ergouser/Zivan-NG3/Circuit board pinout.xlsx

5V | 5v | D13 | CLK |  | D12 |  | GND
WDO | A0* | 3v3 |  | SDI | D11 | D9* | Soft Start
 |  | REF |  | CS | D10 | D8* | LED RED
 |  | A0 | WDO | SS | D9 | D7* | LED GREEN
 |  | A1 | Current | LED RED | D8
FANS | A3* | A2 | Voltage | LED GREEN | D7 |  | C0
CS | D10 | A3 | FANS | SOUNDER | D6 |  | C1
SDI | D11 | A4 | SDA screen |  | D5 |  | TP
CLK | D13 | A5 | SCL screen |  | D4 |  | AH
 |  | A6 | Over temp (can't output) |  | D3 | A1* | CURRENT
 |  | A7 | (can't output) |  | D2 | A2* | VOLTAGE
AUX2 |  | 5V | Screen+ |  | GND
AUX1 |  | RST |  |  | RST |  | EXT_TEMP
SOUNDER | D6* | GND | Screen- |  | RX0 | A6* | Over temp
 |  | VIN |  |  | TX1
 |  |  | * = changed comp to previous
