ergouser/Zivan-NG3/(list of files, cad)

Other CAD files:
Zivan NG3 customcircuits dave/Firmware/startup.obj
Zivan NG3 customcircuits dave/Firmware/NGC.obj
