ergouser/Zivan-NG3/Zivan NG3 customcircuits dave/Old_NG3_logic.pdf

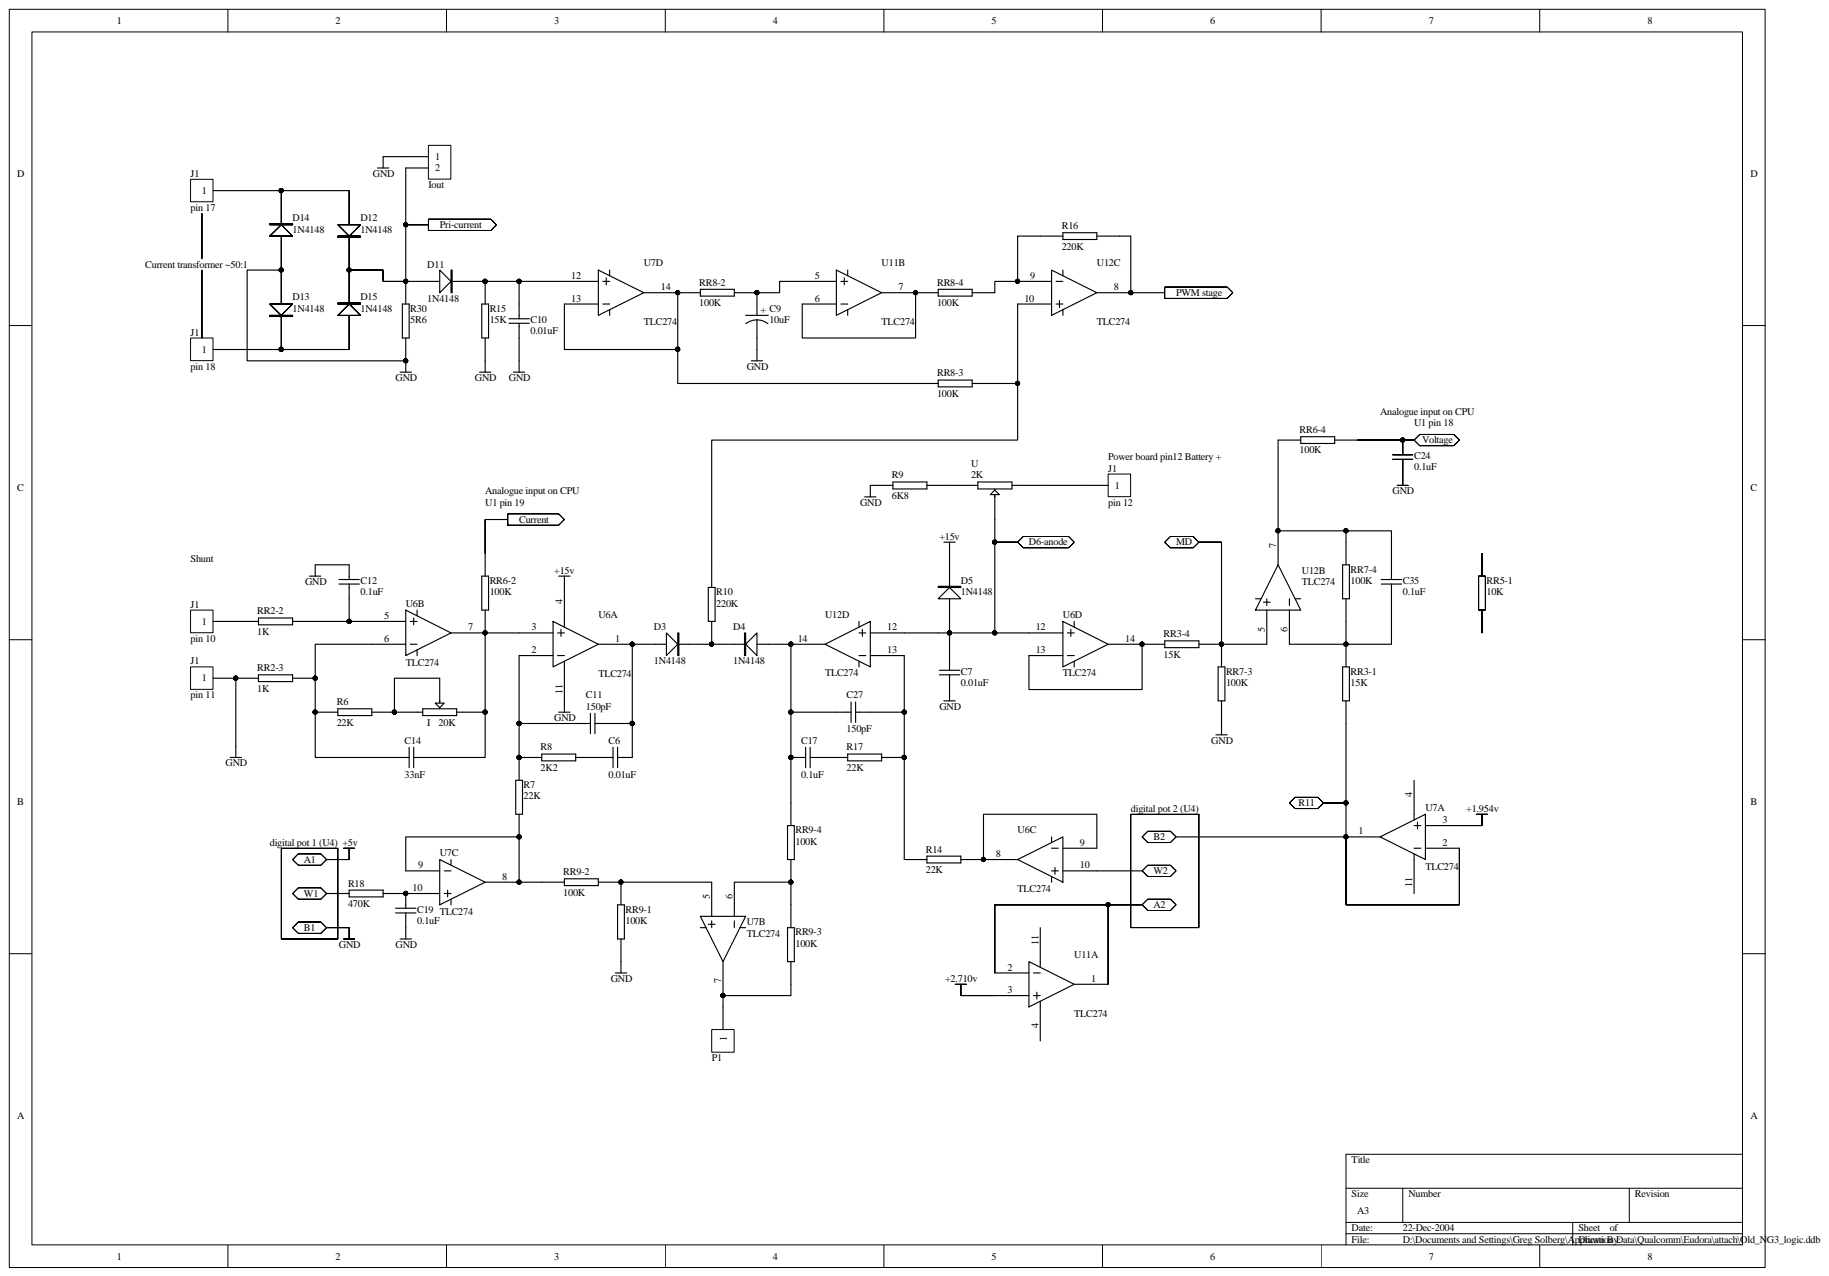
[picture p18: page 1]

Analogue input on CPU

U1 pin 19

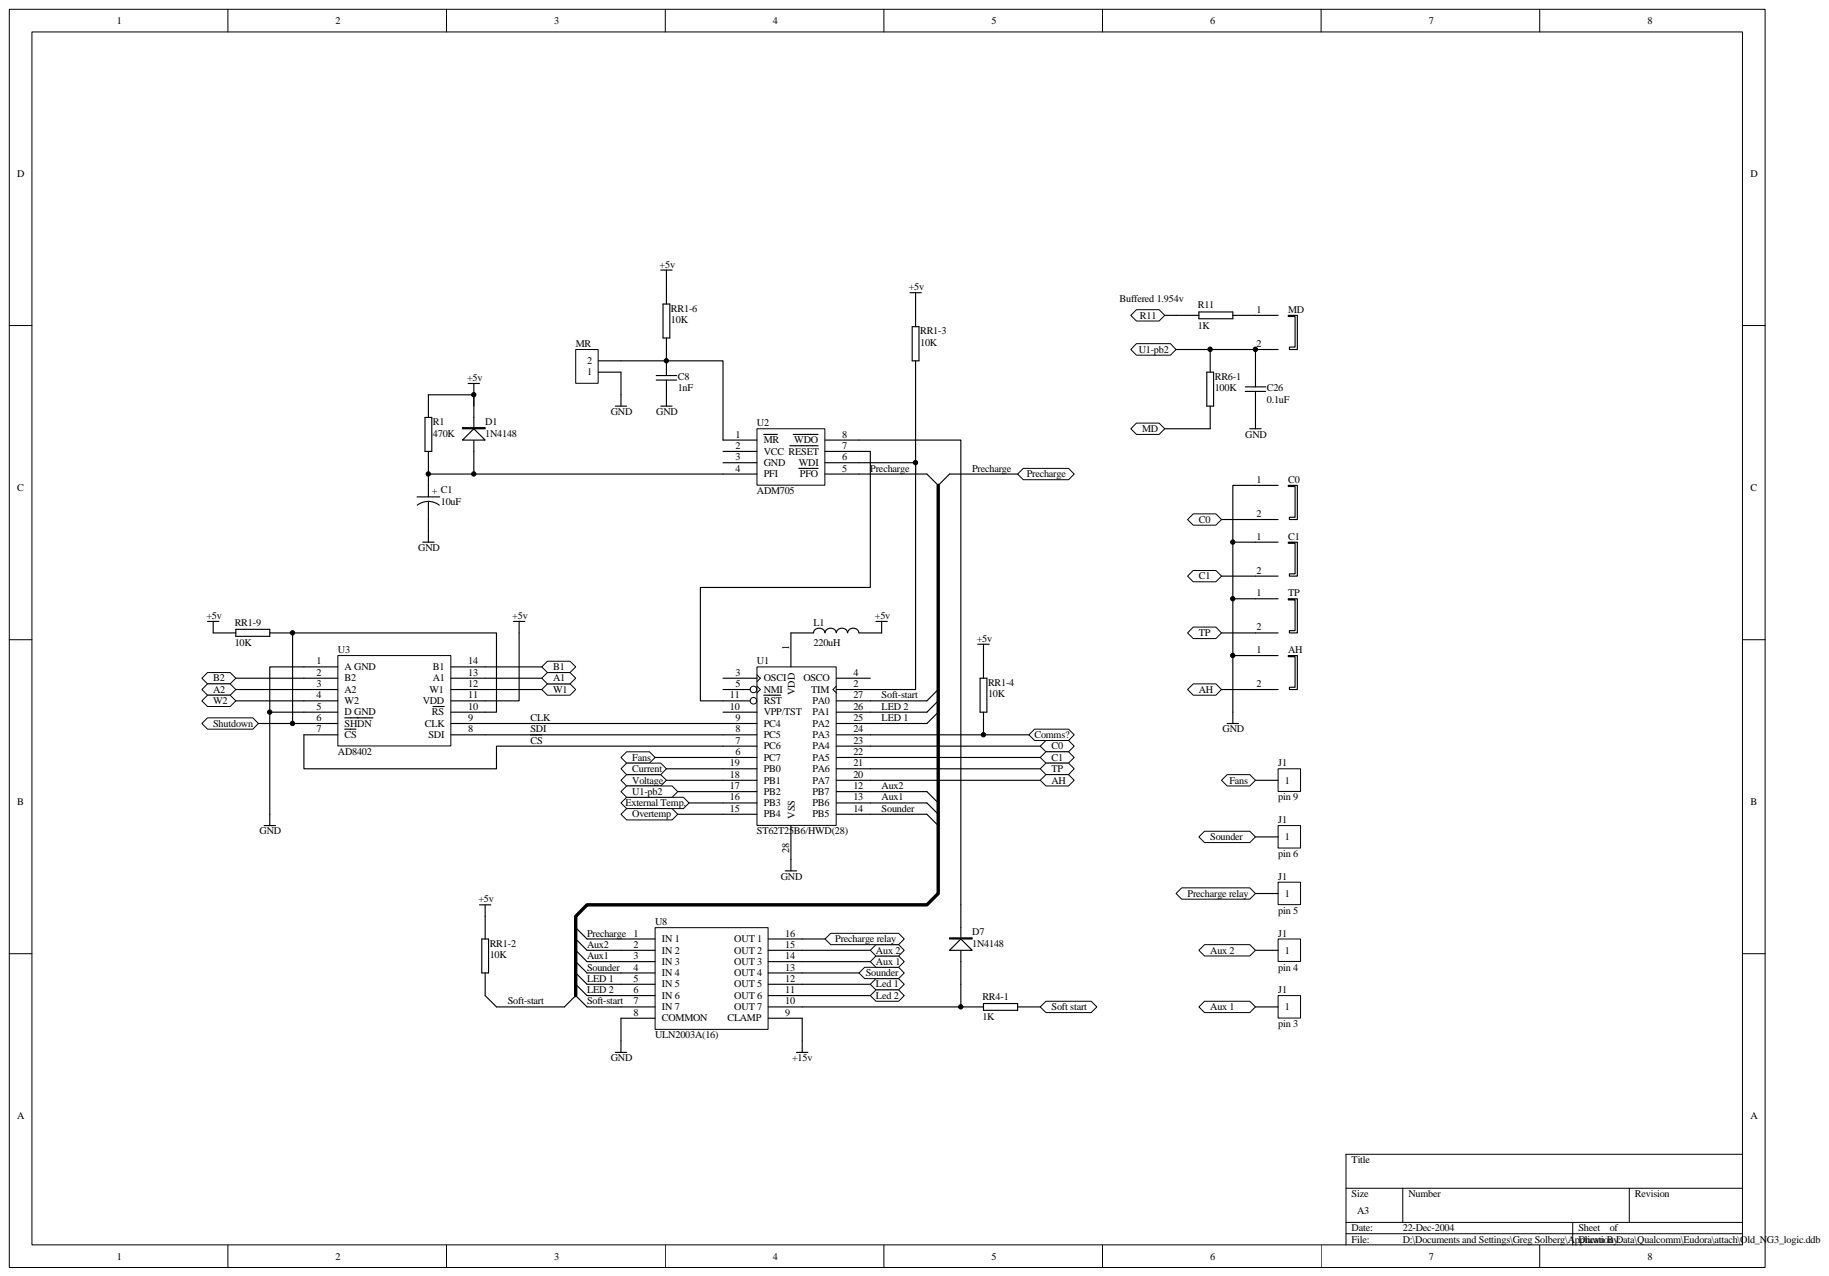
[picture p19: page 2]

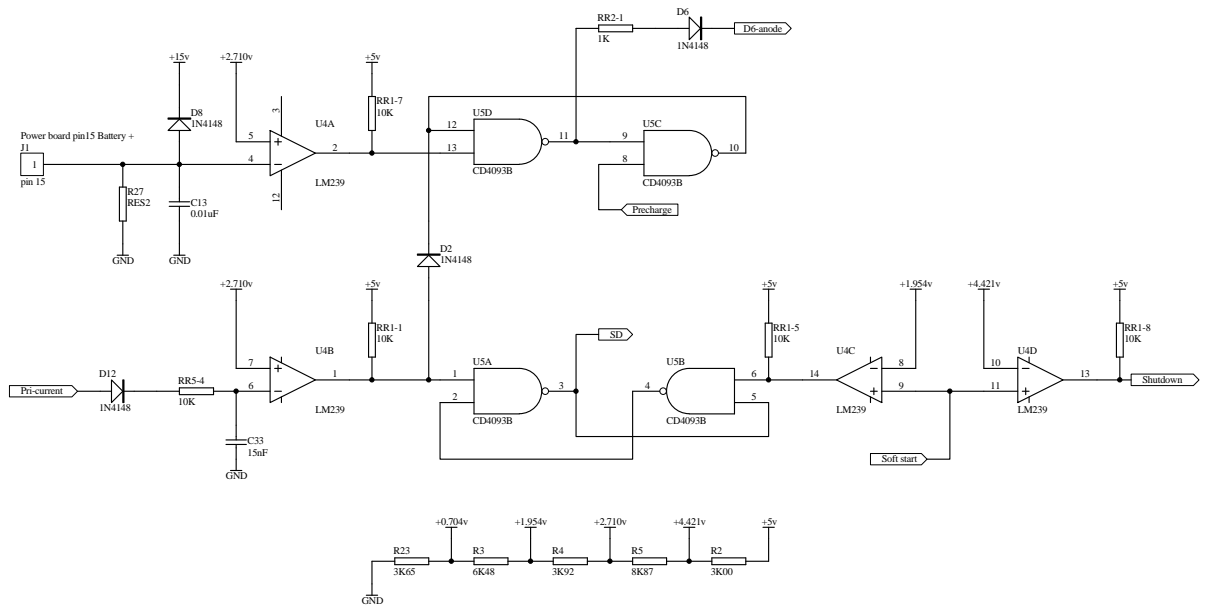
[picture p20: page 3]

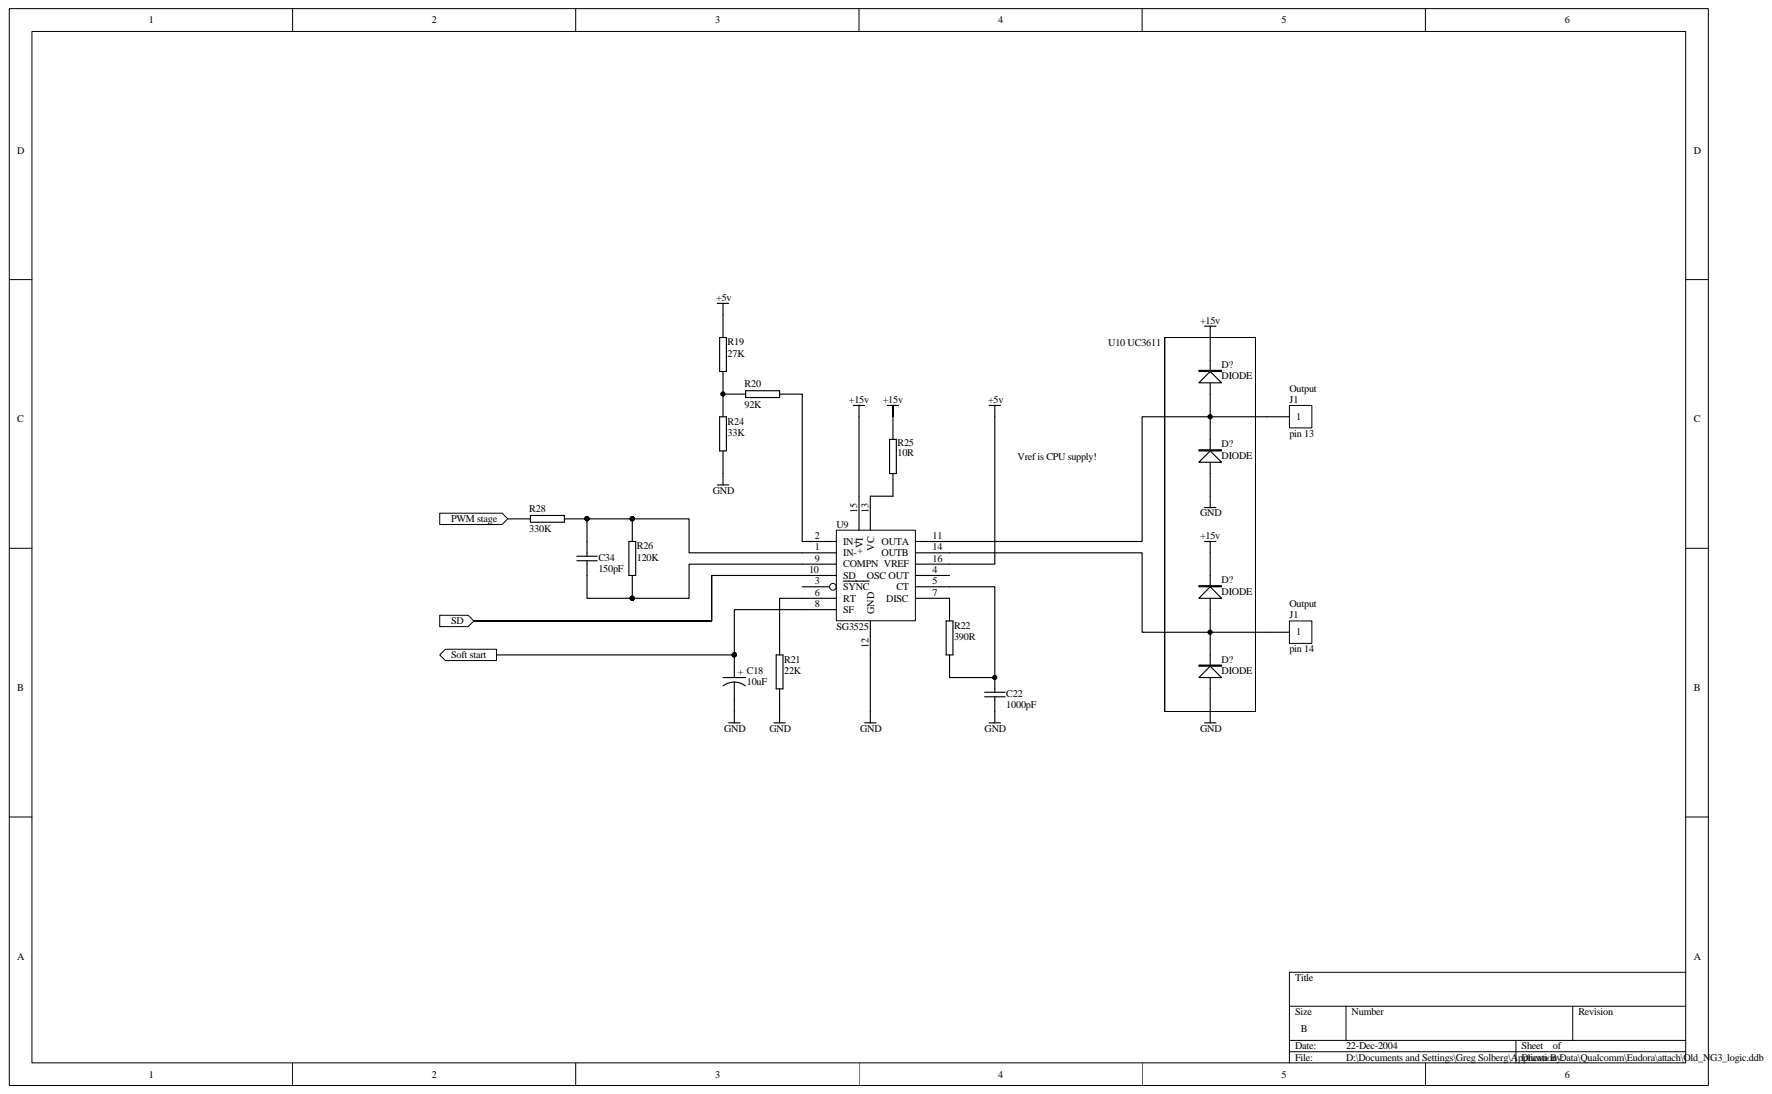
[picture p21: page 4]

Vref is CPU supply!

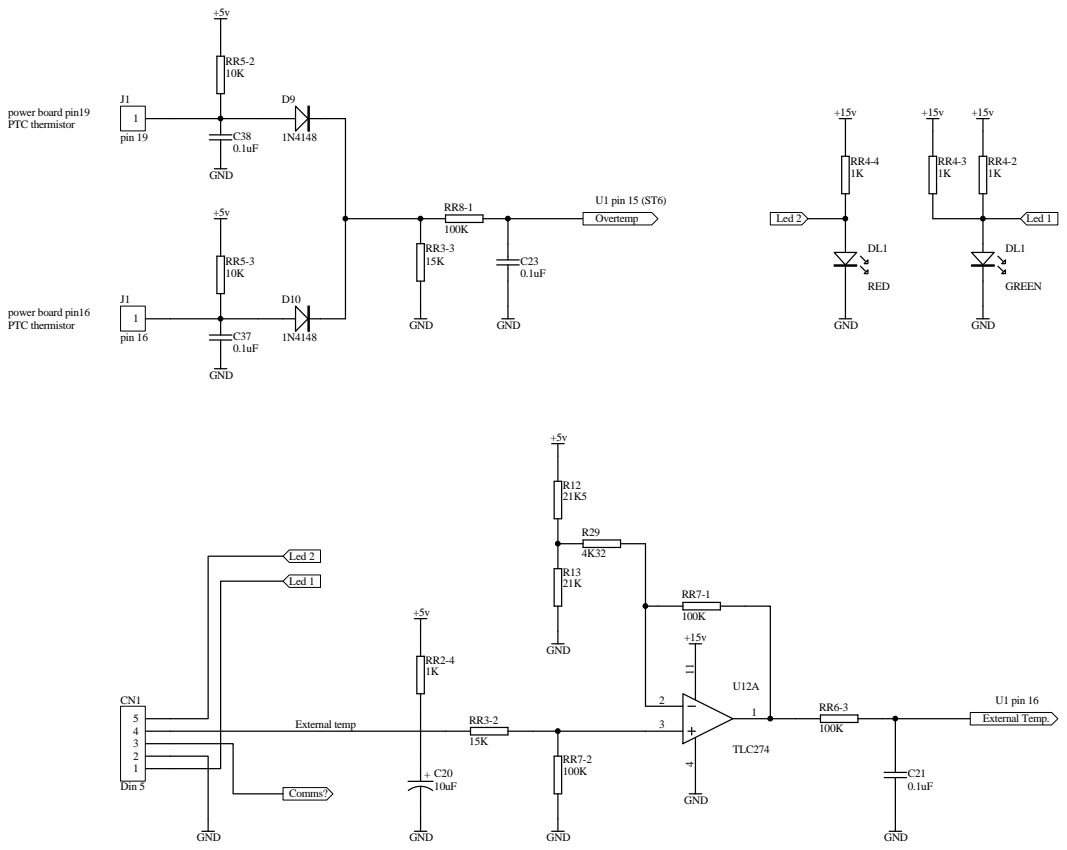
[picture p22: page 5]

1 | 2 | 3 | 4 | 5 | 6

A

B

C

D

1 | 2 | 3 | 4 | 5 | 6

D

C

B

A

Title

B
