ergouser/Zivan-NG3/(commit log)

2022-11-21 Zivan NG3 Arduino V1
2022-12-28 Socketed CPU pin-out to Arduino
    Added schematics
2023-02-10 Version 0.9
    Updated readme
    Added images
    Added overtemp control
    Added self reset feature
    [Display.cpp, Display.h, definitions.h, main.cpp]
2023-05-07 Update PIN CHANGE
    !!!!!Pin-out change!!!!!
    > Created myself a circuitboard.
    > changed readme
    > removed TP header stuff, let's just do it through software...
    > added an alternative current sensing scheme. Absolutely NO clue if this is correct. define alternative_current
    Good luck!
    [Circuit board pinout.xlsx]
2024-01-08 Last update to this project.. includes capacity measurement - on screen (of unknown accuracy)
    It has been shortly tested, however these are my last efforts on this!
    [Display.cpp, Display.h, main.cpp]
2024-05-05 Added files from customcircuitsolutions
    Thanks to Dave from customcircuitsolutions!!
    [ArduinoIO.xlsx, NGC.obj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]
