ergouser/Zivan-NG3/images/connected.jpg

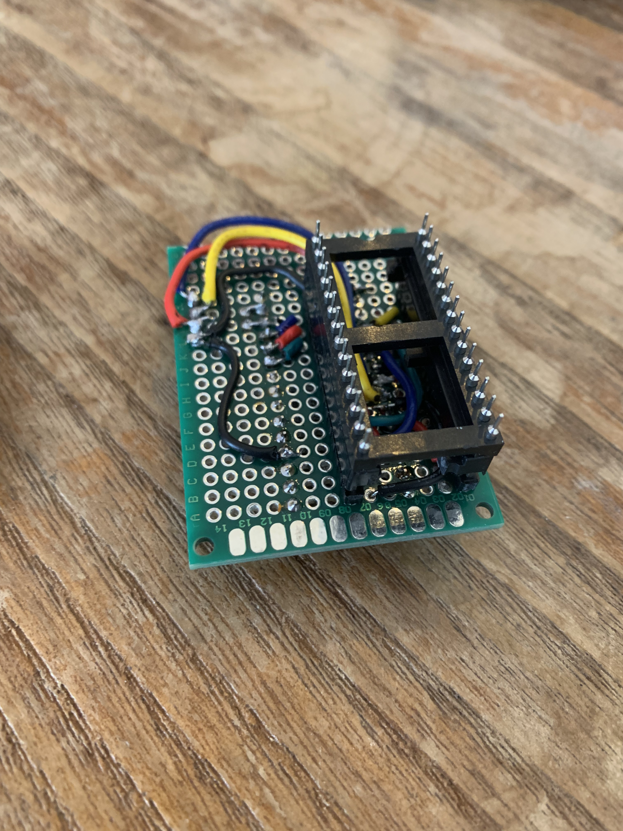
[picture p2: images/connected.jpg]
images/connected.jpg
