ergouser/Zivan-NG3/images/circuit_board.jpg

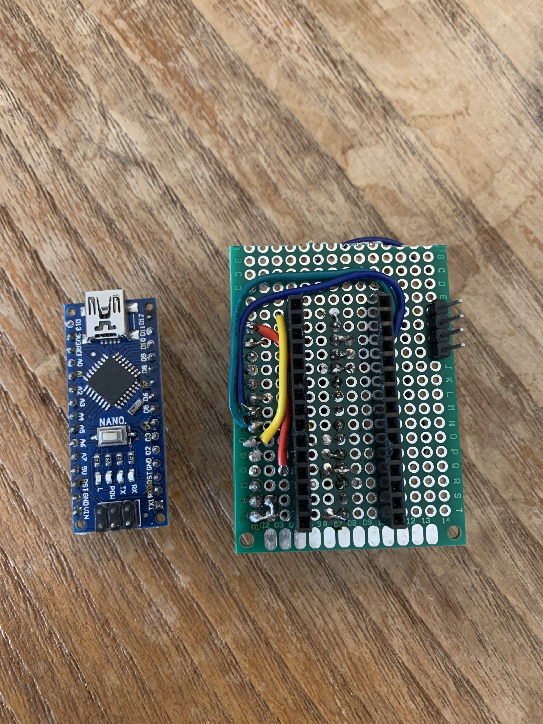
[picture p3: images/circuit_board.jpg]
images/circuit_board.jpg
