ergouser/Zivan-NG3/images/Builtin.jpg

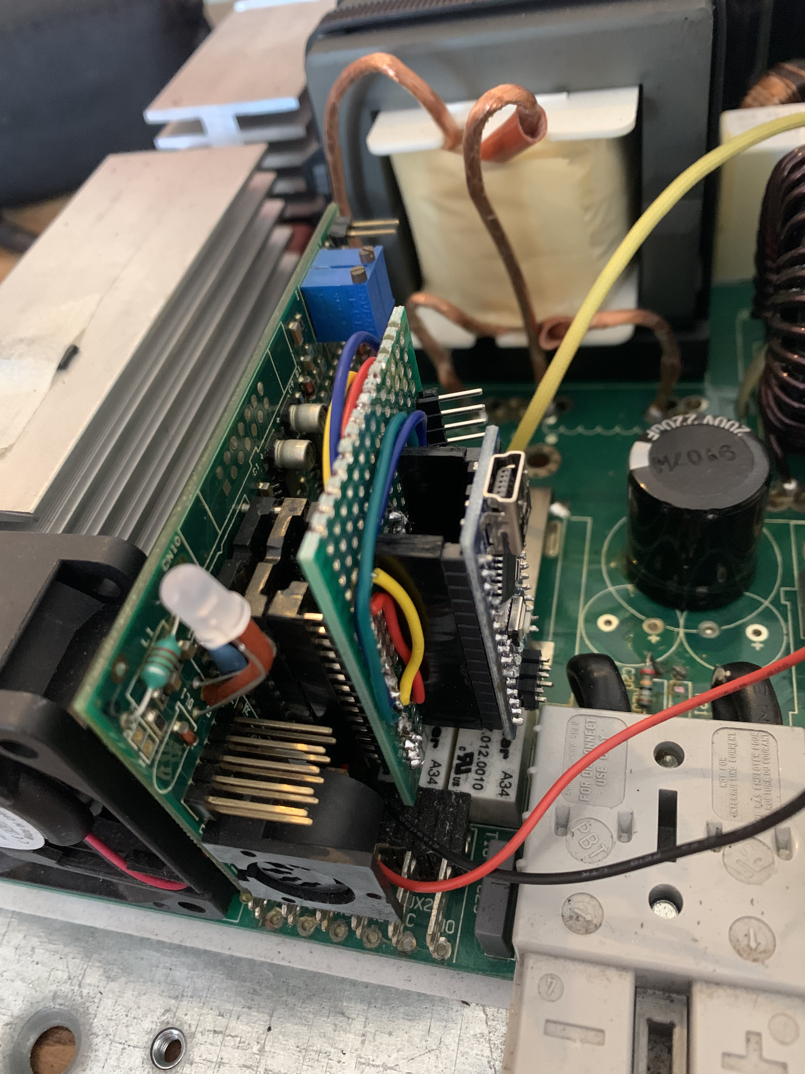
[picture p5: images/Builtin.jpg]
images/Builtin.jpg
