ergouser/Zivan-NG3/images/detail.jpg

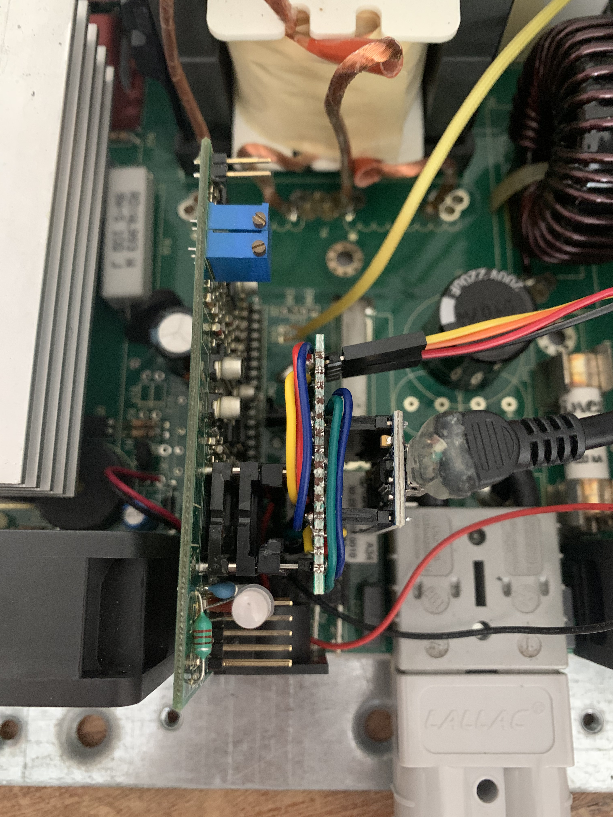
[picture p6: images/detail.jpg]
images/detail.jpg
